diorcety/ESPilot/PCB/wemos-d1-mini-kicad-master/README.md

 wemos-d1-mini-kicad
==============
KiCAD

* library, 
* footprint and 
* 3D shape 

of the WeMos D1 mini board. 

The library provides several footprints and shape alignments:

butler 3d view
butler 3d view
butler 3d view
butler 3d view
