diorcety/ESPilot/3DBox/ESPPilotBoxLeft.stl

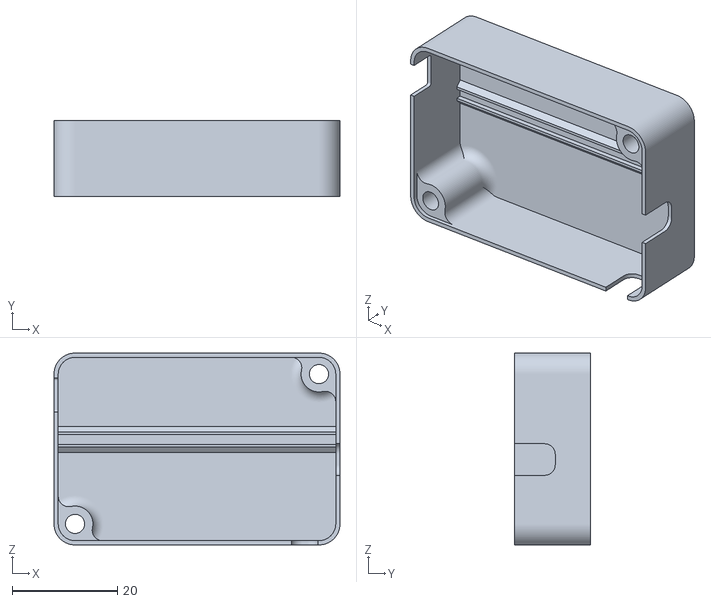
[picture p1: CAD file, 2024-02-27]
3DBox/ESPPilotBoxLeft.stl
54.4 x 14.4 x 36.5
