diorcety/ESPilot/3DBox/ESPilotBox.step

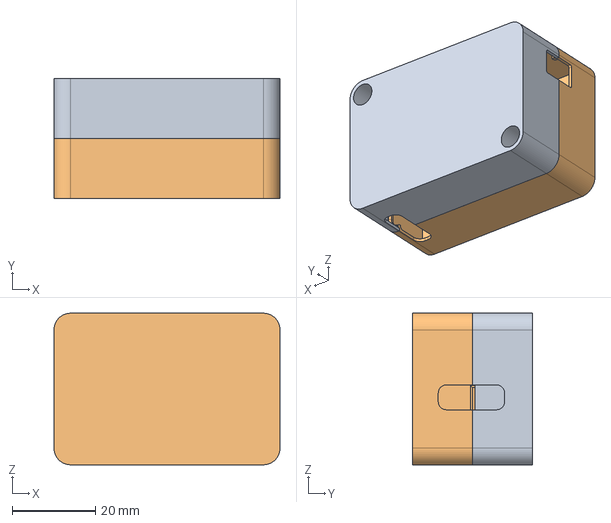
[picture p2: CAD file, 2024-02-27]
3DBox/ESPilotBox.step
54.4 x 28.9 x 36.5 mm
