diorcety/ESPilot/PCB/ESPilot.step

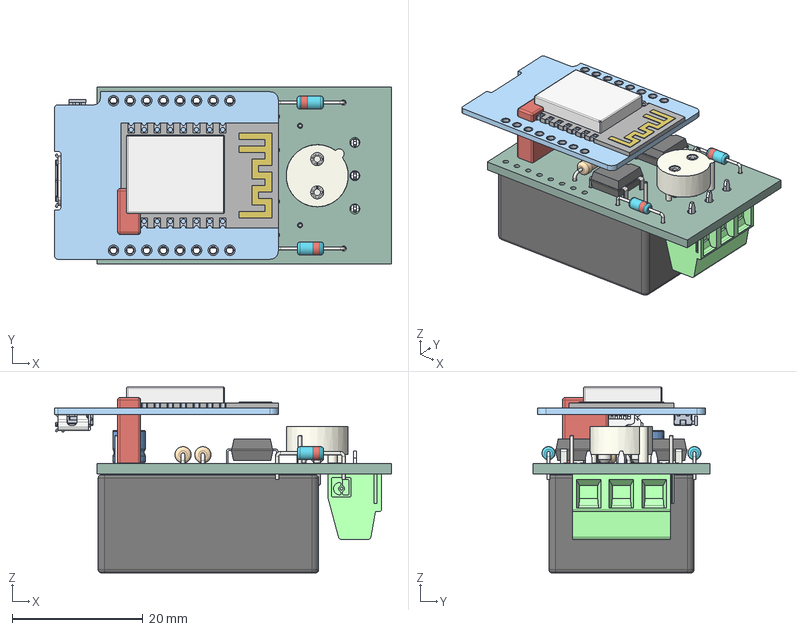
[picture p3: CAD file, 2024-02-27]
PCB/ESPilot.step
51.5 x 27.0 x 28.4 mm
R_Axial_DIN0207_L63mm_D25mm_P1016mm_Horizontal x 2
DIP_5_6_W762mm x 2
D_DO-35_SOD27_P10.16mm_Horizontal x 2
wemos_d1_mini x 2
C_Rect_L70mm_W35mm_P250mm_P500mm
A_Littelfuse_No560_No460
CP_Radial_D50mm_P200mm
Converter_ACDC_MeanWell_IRM_02_xx_THT
ESPilot_PCB
