diorcety/ESPilot/3DBox/ESPPilotBoxRight.stl

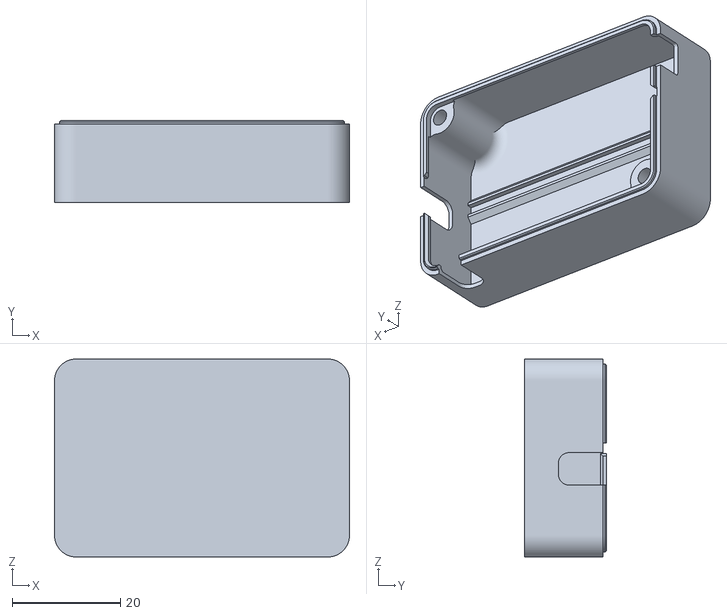
[picture p4: CAD file, 2024-02-27]
3DBox/ESPPilotBoxRight.stl
54.4 x 15.0 x 36.5
