diorcety/ESPilot/PCB/1729021.step

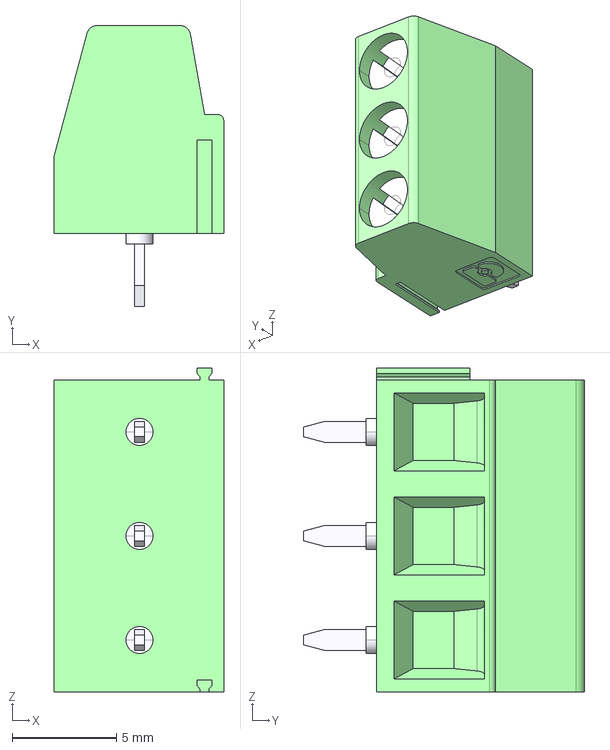
[picture p5: CAD file, 2024-02-27]
PCB/1729021.step
8.15 x 13.5 x 15.6 mm
