diorcety/ESPilot/(list of files, cad)

Other CAD files:
3DBox/ESPilotBox.f3z
