diorcety/ESPilot/PCB/out/ESPilot.pdf

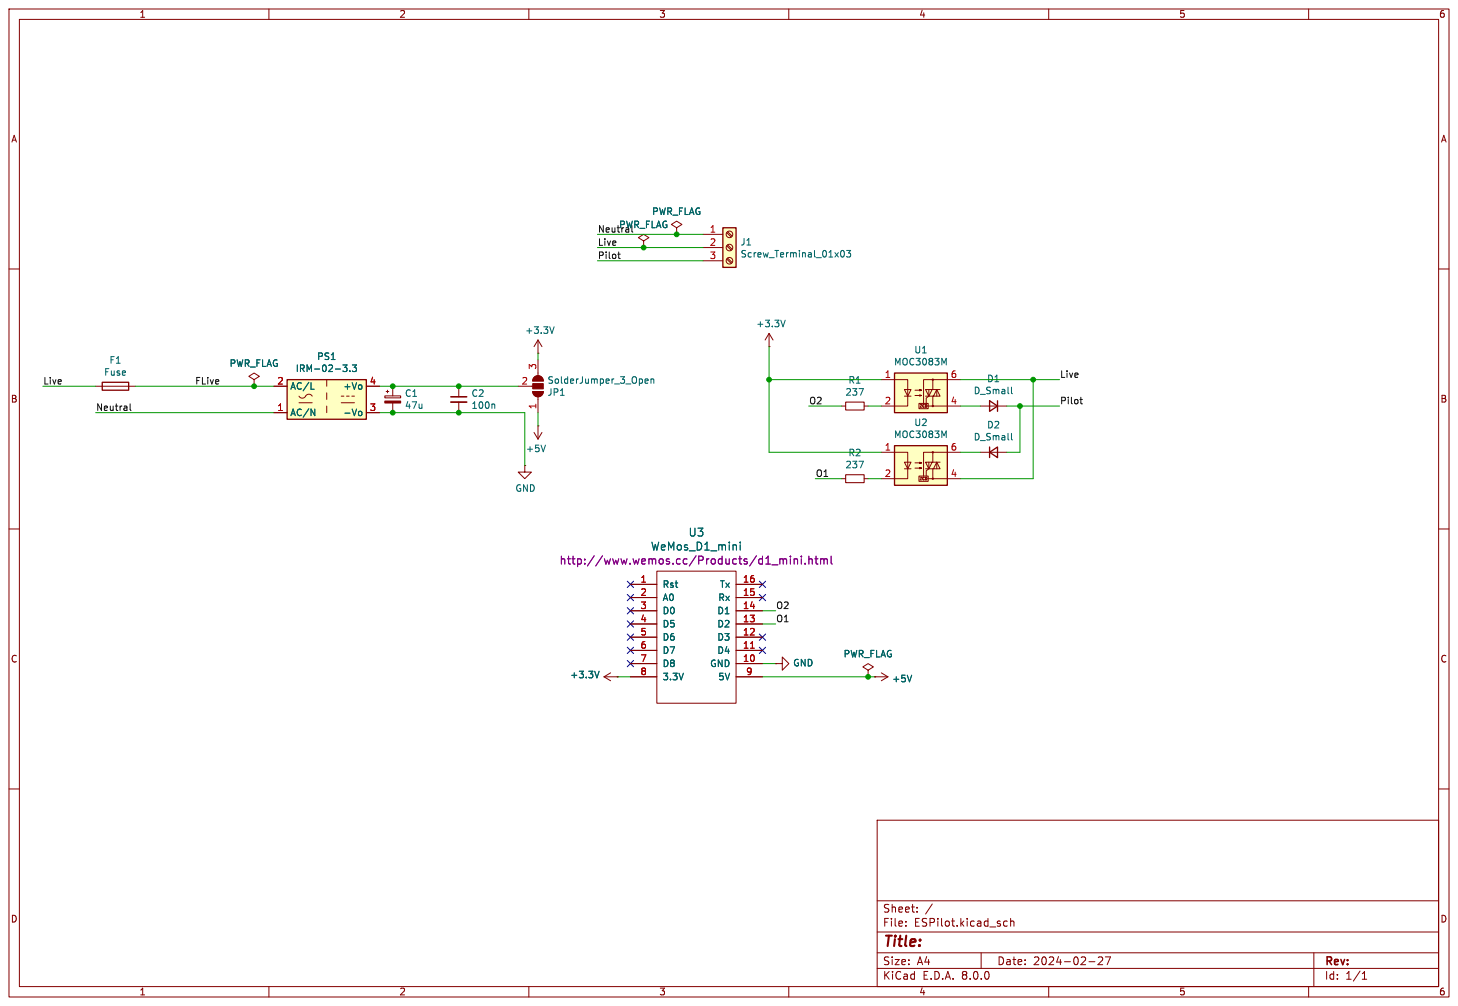
[picture p6: page 1]

http://www.wemos.cc/Products/d1_mini.html

Id: 1/1 Title: File: ESPilot.kicad_sch Sheet: / GND
