diorcety/ESPilot/PCB/out/ESPilot-B_Cu.pdf

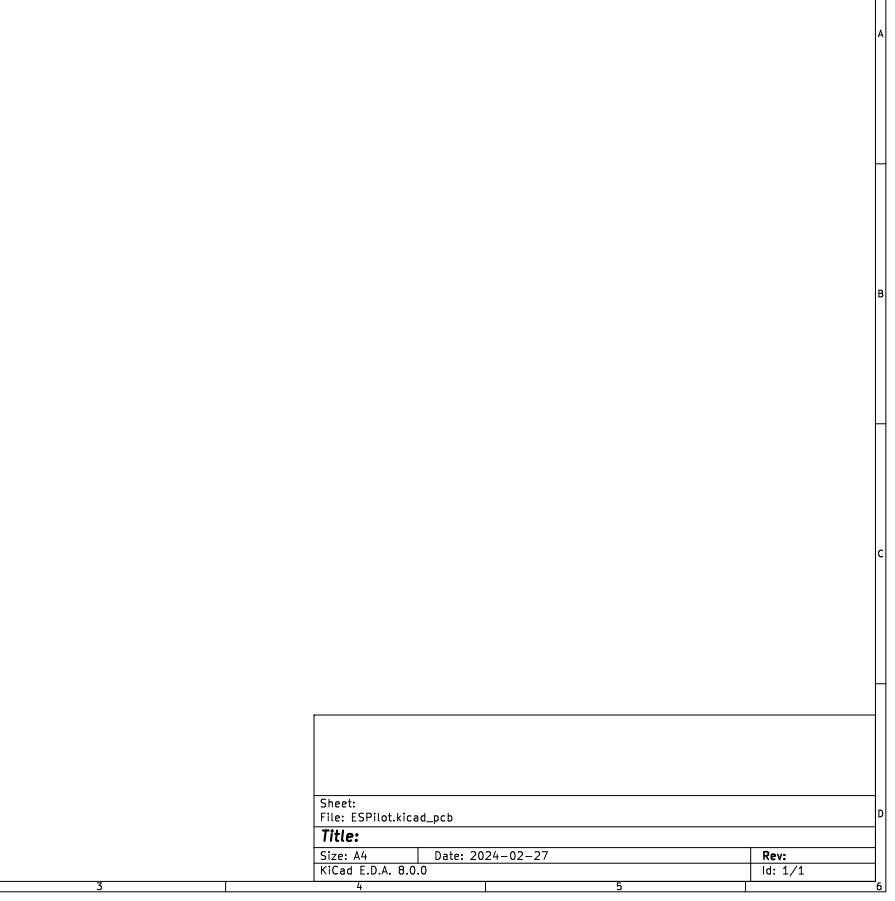
[picture p7: page 1]
