diorcety/ESPilot/PCB/out/ESPilot-Edge_Cuts.pdf

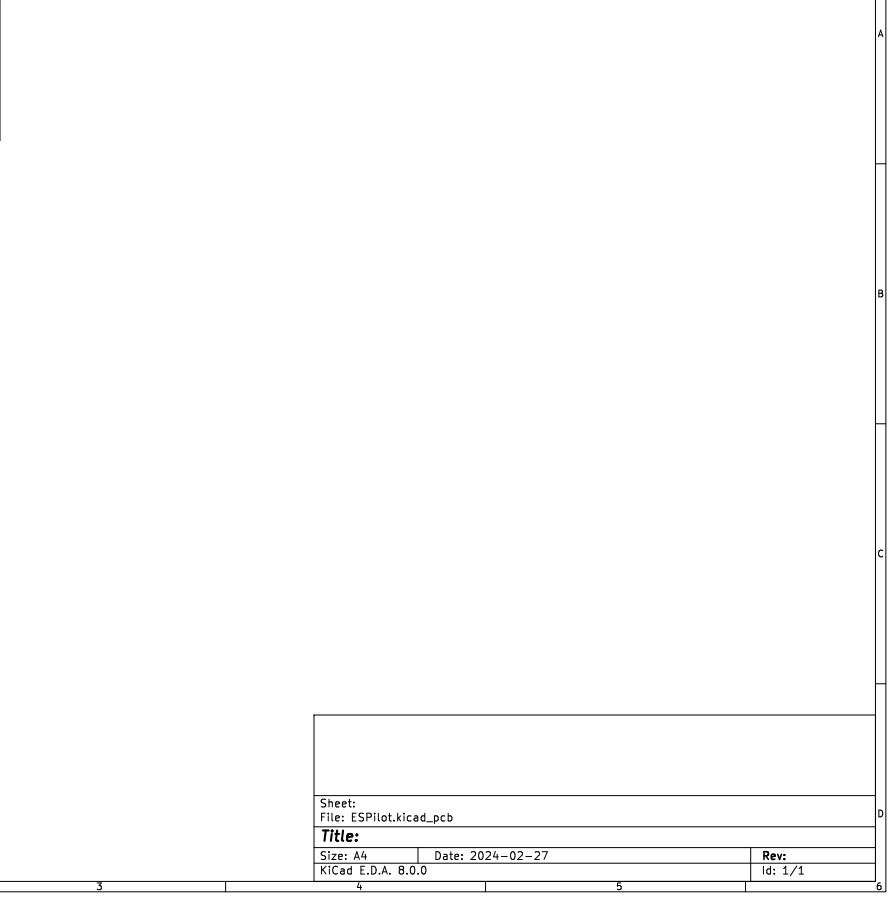
[picture p8: page 1]
