diorcety/ESPilot/PCB/ESPilot.kicad_pcb

## KiCad design PCB/ESPilot.kicad_pcb (2024-02-27)

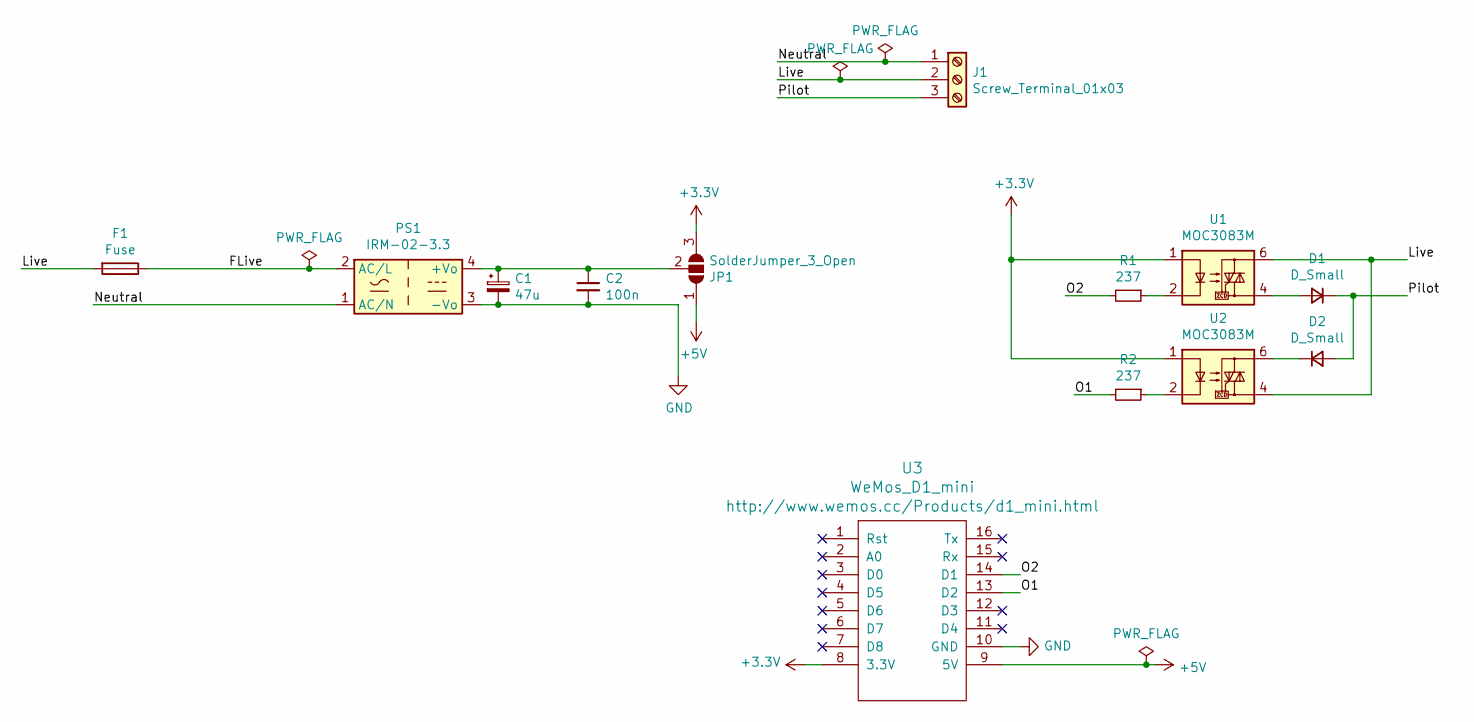
[picture p9: schematic ESPilot.kicad_sch]

Parts:
C1: 47u; CP_Radial_D5.0mm_P2.00mm
C2: 100n; C_Rect_L7.0mm_W3.5mm_P2.50mm_P5.00mm
D1, D2: D_Small; D_DO-35_SOD27_P10.16mm_Horizontal
F1: Fuse; Fuseholder_TR5_Littelfuse_No560_No460
J1: Screw_Terminal_01x03; TerminalBlock_bornier-3_P5.08mm
JP1: SolderJumper_3_Open; SolderJumper-3_P2.0mm_Open_TrianglePad1.0x1.5mm
PS1: IRM-02-3.3; Converter_ACDC_MeanWell_IRM-02-xx_THT
R1, R2: 237; R_Axial_DIN0207_L6.3mm_D2.5mm_P10.16mm_Horizontal
U1, U2: MOC3083M; DIP-5-6_W7.62mm
U3: WeMos_D1_mini; wemos-d1-mini-with-pin-header-and-connector

Connections:
+3V3: JP1.3 (B), U1.1, U2.1, U3.8 (3.3V)
+5V: JP1.1 (A), U3.9 (5V)
/FLive: F1.1, PS1.2 (AC/L)
/Live: F1.2, J1.2, U1.6, U2.4
/Neutral: J1.1, PS1.1 (AC/N)
/O1: R2.2, U3.13 (D2)
/O2: R1.2, U3.14 (D1)
/Pilot: D1.1 (K), D2.2 (A), J1.3
GND: C1.2, C2.2, PS1.3 (-Vo), U3.10 (GND)
unnamed: C1.1, C2.1, JP1.2 (C), PS1.4 (+Vo)
unnamed: D1.2 (A), U1.4
unnamed: D2.1 (K), U2.6
unnamed: R1.1, U1.2
unnamed: R2.1, U2.2

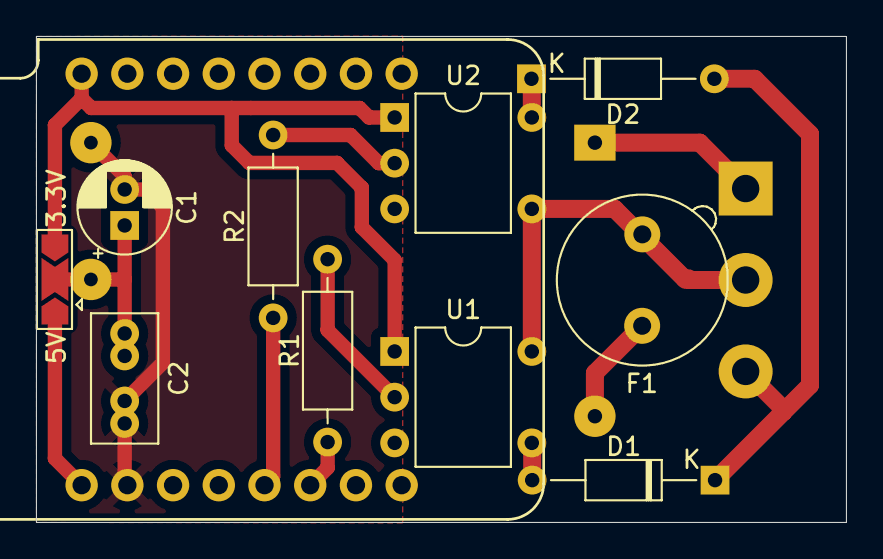
[picture p10: board ESPilot.kicad_pcb from above]

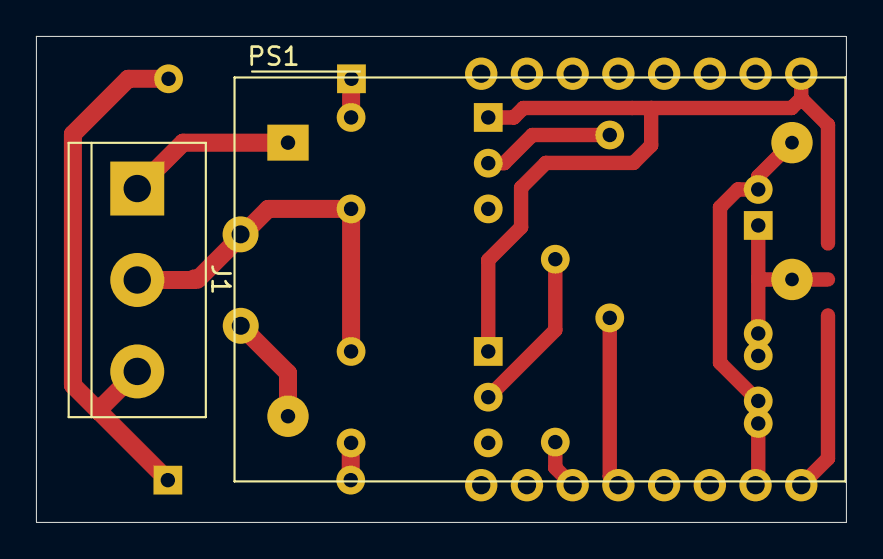
[picture p11: board ESPilot.kicad_pcb from below]

Board: 2 copper layers, 45.0 x 27.0 mm, 13 parts (2 on the bottom side), 14 nets.
