diorcety/ESPilot/(threads)

Thread 1 (2024-07-11):

No problem, works very fine !

Indianagrenoble, 2024-07-11:
Just implement some sensors on your code my friend !
`esphome:
  name: fil-pilote-esp
  friendly_name: Fil Pilote ESP
  on_boot:
    then:
      - script.execute: update_output

esp8266:
  board: esp01_1m
  restore_from_flash: true

preferences:
    flash_write_interval: 10min

# Enable logging
logger:

# Enable Home Assistant API
api:
  encryption:
    key: "UZYAjp0pUUspRVeAXgpAvFwhlgZw+4VjRrBIKn0uquc="
  reboot_timeout: 15s

ota:
  platform: esphome
  password: "51eba79c48e96005fa8a27f963a6f429"

wifi:
  ssid: !secret wifi_ssid
  password: !secret wifi_password

  manual_ip:
    static_ip: 10.10.10.135
    gateway: 10.10.10.1
    subnet: 255.255.255.0
    dns1: 10.10.10.1
  fast_connect: true
  reboot_timeout : 30s
  power_save_mode: none
  output_power: 20.4 dB

  # Enable fallback hotspot (captive portal) in case wifi connection fails
  ap:
    ssid: "Fil-Pilote-Esp Fallback Hotspot"
    password: "012345678"
    ap_timeout: 1min

captive_portal:

web_server:
    port: 80
    auth:
        username: admin
        password: flyerflyer

select:
  - platform: template
    id: order
    name: "Order"
    optimistic: true
    options:
      - Confort
      - Réduit
      - Hors-Gel
      - Stop
    restore_value: yes
    initial_option: Hors-Gel
    on_value:
      then:
        - script.execute: update_output

script:
  - id: update_output
    then:
      - logger.log:
          format: "Order pilote: %s"
          args: ["id(order).state.c_str()"]
      - if:
          condition:
            - lambda: |-
                return (strcmp(id(order).state.c_str(), "Stop") == 0);
          then:
            lambda: |-
              id(gpio_neg).turn_off();
              id(gpio_pos).turn_on();
      - if:
          condition:
            - lambda: |-
                return (strcmp(id(order).state.c_str(), "Hors-Gel") == 0);
          then:
            lambda: |-
              id(gpio_neg).turn_on();
              id(gpio_pos).turn_off();
      - if:
          condition:
            - lambda: |-
                return (strcmp(id(order).state.c_str(), "Réduit") == 0);
          then:
            lambda: |-
              id(gpio_neg).turn_on();
              id(gpio_pos).turn_on();
      - if:
          condition:
            - lambda: |-
                return (strcmp(id(order).state.c_str(), "Confort") == 0);
          then:
            lambda: |-
              id(gpio_neg).turn_off();
              id(gpio_pos).turn_off();

output:
  - platform: gpio
    pin: 4
    id: gpio_neg
    inverted: true
  - platform: gpio
    pin: 5
    id: gpio_pos
    inverted: true

sensor:
  - platform: uptime
    name: Mise à jour
    id: uptime_sensor_days
    update_interval: 60s
    on_raw_value:
      then:
        - text_sensor.template.publish:
            id: uptime_human
            state: !lambda |-
              int seconds = round(id(uptime_sensor_days).raw_state);
              int days = seconds / (24 * 3600);
              seconds = seconds % (24 * 3600);
              int hours = seconds / 3600;
              seconds = seconds % 3600;
              int minutes = seconds /  60;
              seconds = seconds % 60;
              return (
                (days ? String(days) + "d " : "") +
                (hours ? String(hours) + "h " : "") +
                (minutes ? String(minutes) + "m " : "") +
                (String(seconds) + "s")
              ).c_str();

time:
  - platform: homeassistant
    id: homeassistant_time

text_sensor:

  - platform: version
    name: Mise à jour le

  - platform: wifi_info
    ip_address:
      name: IP Boitier Fil Pilote
    bssid:
      name: MAC
    ssid:
      name: SSID

  - platform: template
    name: Uptime Human Readable
    id: uptime_human
    icon: mdi:clock-start`

Indianagrenoble, 2024-07-14:
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

Here my fil-pilote.yaml zipped :
[esp-fil-pilote.zip](https://github.com/user-attachments/files/16215964/esp-fil-pilote.zip)

Indianagrenoble, 2024-07-14:
A video on Youtube in french about a all-in-one device in Zigbee (Zigbee2MQTT or ZHA compatible) on the same concept 👍 https://www.youtube.com/watch?v=EiPQo_8WQ5o

Indianagrenoble, 2024-07-14:
Device assembled by @diorcety offered to me
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
